PHREDRobotics/TShirtLauncher/Wiring Diagram/sprinkler valve.jpg

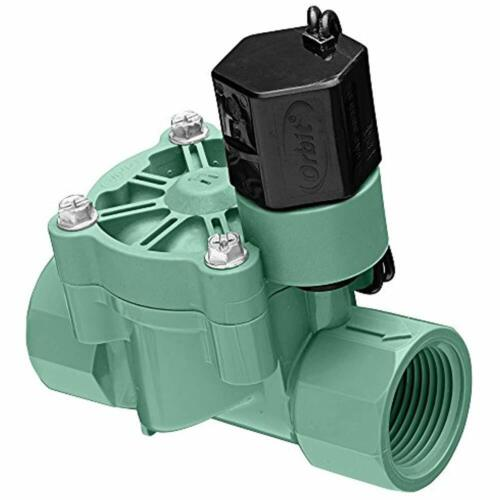
Wiring Diagram/sprinkler valve.jpg
