PHREDRobotics/TShirtLauncher/Wiring Diagram/ArduinoUno.jpg

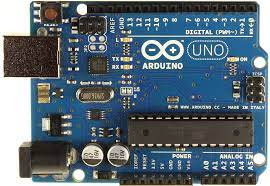
Wiring Diagram/ArduinoUno.jpg
