PHREDRobotics/TShirtLauncher/Wiring Diagram/TShirt Launcher Wiring Diagram.pdf

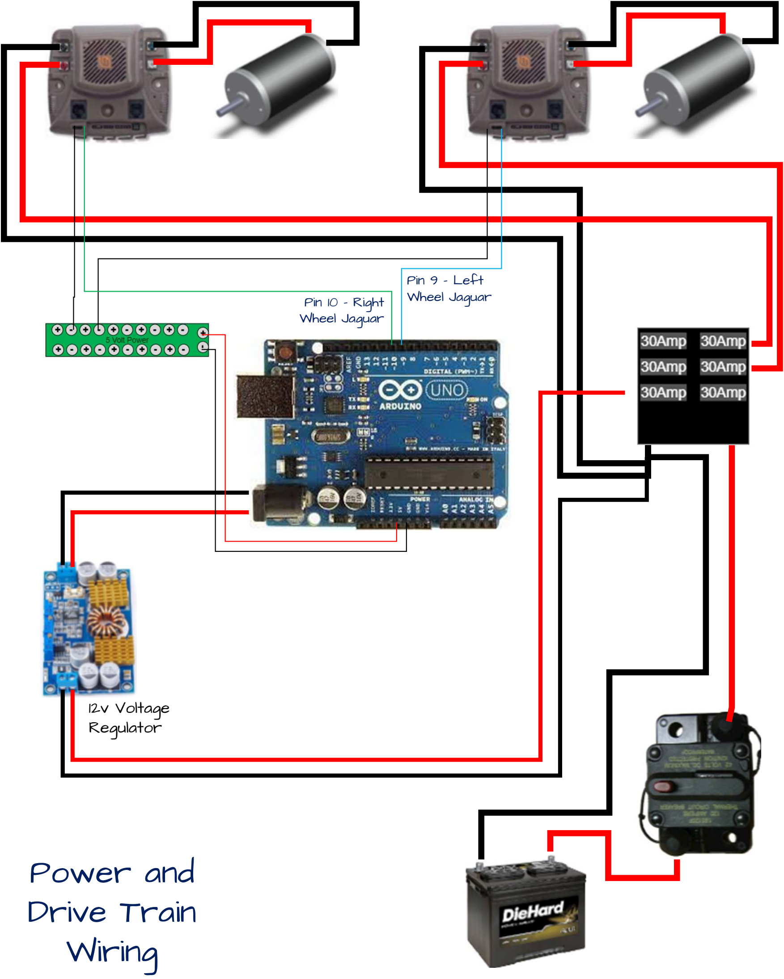
[picture p3: figure]
Power and Drive Train Wiring; Pin 9 – Left Wheel Jaguar Pin 10 – Right Wheel Jaguar; 12v Voltage Regulator

# Firing Mechanism and Control Wiring

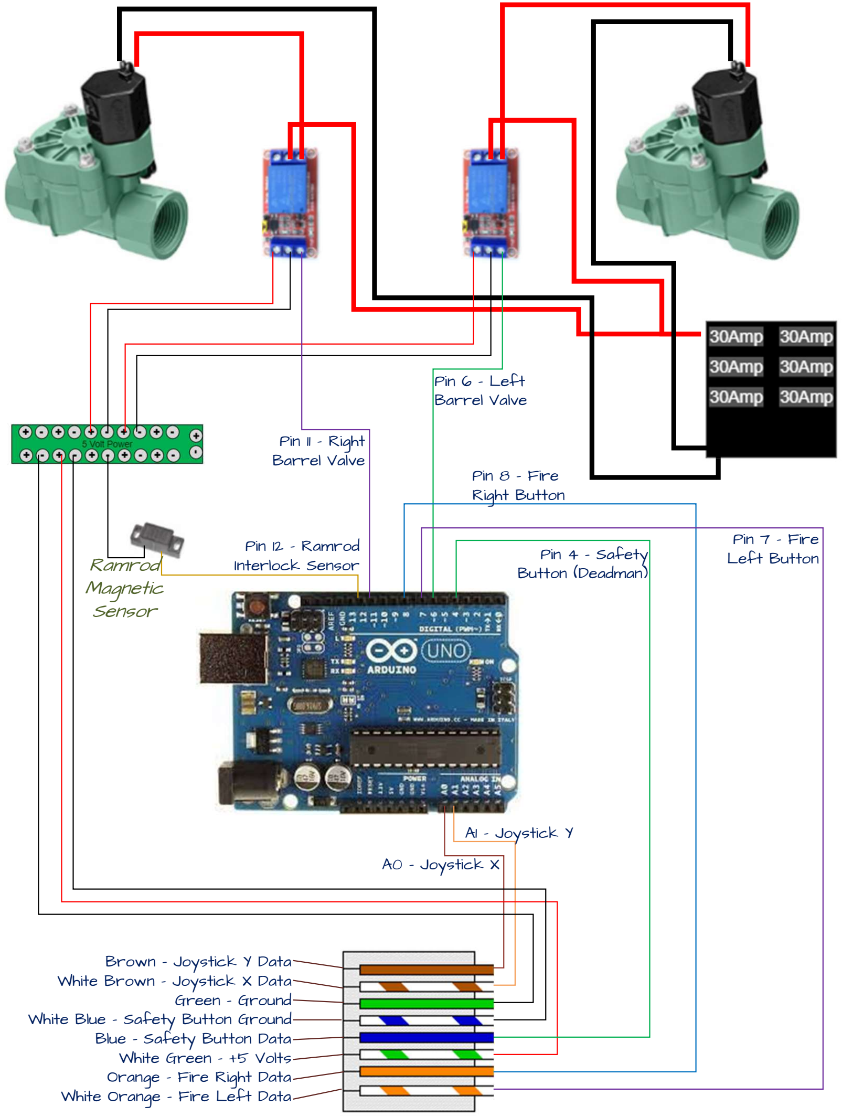
[picture p4: figure]
Pin 6 – Left Barrel Valve; Pin 11 – Right Barrel Valve; Brown – Joystick Y Data White Brown – Joystick X Data Green – Ground White Blue – Safety Button Ground Blue – Safety Button Data White Green - +5 Volts Orange – Fire Right Data White Orange – Fire Left Data; Pin 8 – Fire Right Button; Pin 7 – Fire; Pin 4 – Safety; Left Button; Button (Deadman); A1 – Joystick Y A0 – Joystick X; Pin 12 – Ramrod; Ramrod; Interlock Sensor; Magnetic Sensor

# Air Compressor and LEDs Control Wiring

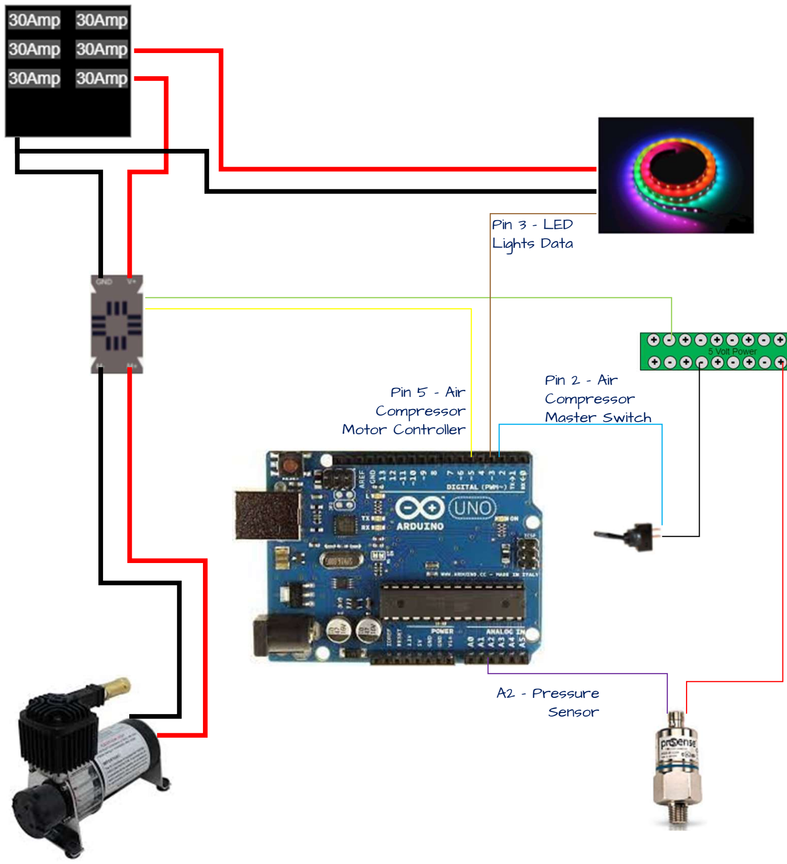
[picture p5: figure]
Pin 2 – Air Compressor Master Switch; Pin 5 – Air Compressor Motor Controller; A2 – Pressure Sensor; Pin 3 – LED Lights Data
