PHREDRobotics/TShirtLauncher/Wiring Diagram/Jaguar Motor Controller.jpg

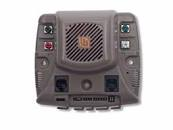
Wiring Diagram/Jaguar Motor Controller.jpg
