PHREDRobotics/TShirtLauncher/Wiring Diagram/StepUpConverter.jpg

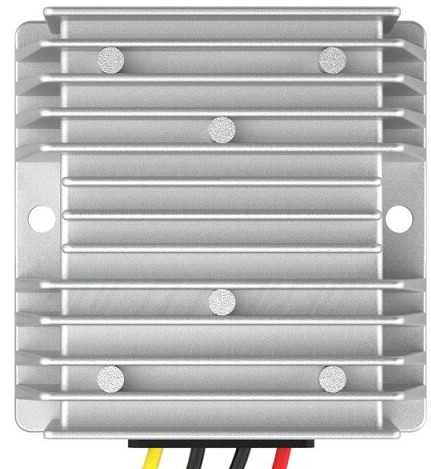
Wiring Diagram/StepUpConverter.jpg
