PHREDRobotics/TShirtLauncher/Wiring Diagram/WS2812B-Addressable-RGB-LED-strip.jpg

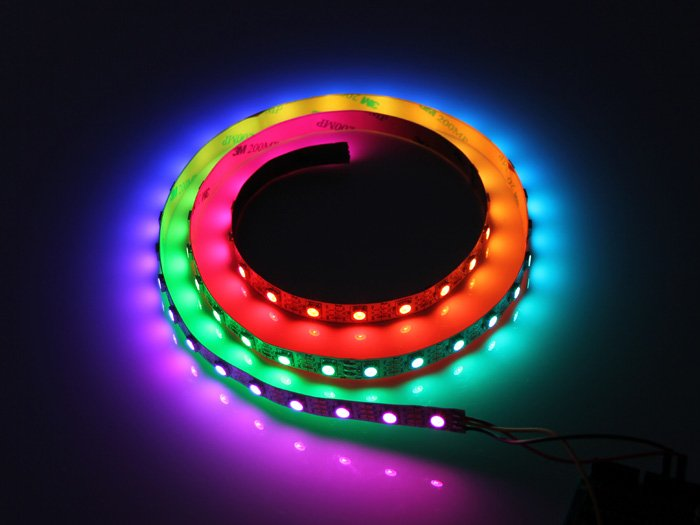
Wiring Diagram/WS2812B-Addressable-RGB-LED-strip.jpg
