PHREDRobotics/TShirtLauncher/(commit log)

2023-02-22 Add Pressure Display Code
2023-06-19 update wire diagram and LED info/process
2023-06-25 update LED Counts
2024-09-30 Minor Bugs and move to Arduino IDE 2.x
    [TShirtLauncher.ino]
2024-09-30 Added Pressed to Button Trackers
